siriscan/MARI-Quadcopter-Drone/README.md

# MARI-Quadcopter-Drone
A final senior project created by Seth Iris Canonigo, Christopher Ruiz-Guerra, Nahom Solomon, and Connor Prior


*(Omori is a good game btw)*

# 3D PCB


Read 'Report.pdf' for the full project writeup.
