siriscan/MARI-Quadcopter-Drone/netlist.txt

Netlist

Exported from UPDATED-PCB.sch at 5/2/2026 4:03 PM

EAGLE Version 9.7.0 Copyright (c) 1988-2026 Autodesk, Inc.

Net                 Part     Pad      Pin        Sheet

BOOT                R6       1        1          1
                    U1       4        !BOOT      1
                    U3       77       PA15       1

FGND                C7       1        1          1
                    L3       2        2          1

GND                 BOOT     1        NC         1
                    C1       2        2          1
                    C10      1        1          1
                    C11      1        1          1
                    C12      1        1          1
                    C13      1        1          1
                    C14      1        1          1
                    C15      1        1          1
                    C2       2        2          1
                    C21      2        2          1
                    C22      2        2          1
                    C23      1        1          1
                    C27      1        1          1
                    C28      1        1          1
                    C29      2        2          1
                    C2A      2        2          1
                    C2B      2        2          1
                    C3       2        2          1
                    C30      2        2          1
                    C31      2        2          1
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
                    U3       36       PB2        1

PB5                 JP3      2        2          1
                    U3       91       PB5        1

PB6                 JP3      1        1          1
                    U3       92       PB6        1

PB12                JP1      1        1          1
                    U3       51       PB12       1

PB13                JP1      2        2          1
                    U3       52       PB13       1

PB13_2              JP2      14       14         1
                    U3       43       PB13_2     1

PB14                JP1      3        3          1
                    U3       53       PB14       1

PB14_2              JP2      15       15         1
                    U3       44       PB14_2     1

PB15                PWM-OUT  7        7          1
                    U3       54       PB15       1

PC1                 U$13     1        1          1
                    U3       16       PC1        1

PC2                 U$13     2        2          1
                    U3       17       PC2        1

PC3                 U$13     3        3          1
                    U3       18       PC3        1

PC4                 JP2      3        3          1
                    U3       32       PC4        1

PC5                 JP2      4        4          1
                    U3       33       PC5        1

PC6                 PWM-OUT  3        3          1
                    U3       63       PC6        1

PC7                 JP1      11       11         1
                    U3       64       PC7        1

PC8                 JP1      12       12         1
                    U3       65       PC8        1

PC9                 JP1      13       13         1
                    U3       66       PC9        1

PC10                JP3      13       13         1
                    U3       78       PC10       1

PC11                JP3      12       12         1
                    U3       79       PC11       1

PC12                JP3      11       11         1
                    U3       80       PC12       1

PD0                 INT      TP       TP         1
                    U1       14       !H_INT     1
                    U3       81       PD0        1

PD1                 TP1      TP       TP         1
                    U3       82       PD1        1
                    U4       7        INT        1

PD2                 JP3      8        8          1
                    U3       83       PD2        1

PD3                 JP3      7        7          1
                    U3       84       PD3        1

PD4                 JP3      6        6          1
                    U3       85       PD4        1

PD5                 JP3      5        5          1
                    U3       86       PD5        1

PD6                 JP3      4        4          1
                    U3       87       PD6        1

PD7                 JP3      3        3          1
                    U3       88       PD7        1

PD8                 JP1      4        4          1
                    U3       55       PD8        1

PD9                 JP1      5        5          1
                    U3       56       PD9        1

PD10                JP1      6        6          1
                    U3       57       PD10       1

PD11                JP1      7        7          1
                    U3       58       PD11       1

PD12                PWM-IN   7        7          1
                    U3       59       PD12       1

PD13                JP1      8        8          1
                    U3       60       PD13       1

PD14                JP1      9        9          1
                    U3       61       PD14       1

PD15                JP1      10       10         1
                    U3       62       PD15       1

PE2                 U$1      1        1          1
                    U3       1        PE2        1

PE3                 U$1      2        2          1
                    U3       2        PE3        1

PE4                 U$1      3        3          1
                    U3       3        PE4        1

PE5                 PWM-OUT  5        5          1
                    U3       4        PE5        1

PE6                 U$1      4        4          1
                    U3       5        PE6        1

PE7                 JP2      8        8          1
                    U3       37       PE7        1

PE8                 JP2      9        9          1
                    U3       38       PE8        1

PE9                 PWM-OUT  1        1          1
                    U3       39       PE9        1

PE10                JP2      11       11         1
                    U3       40       PE10       1

PE11                JP2      12       12         1
                    U3       41       PE11       1

PE12                JP2      13       13         1
                    U3       42       PE12       1

PE15                JP2      16       16         1
                    U3       45       PE15       1

RXD                 LORA     4        4          1
                    U3       97       PE0        1

SCL                 R17      1        1          1
                    SCL0     TP       TP         1
                    U1       19       H_SCL/SCK/RX 1
                    U3       46       PB10       1

SCL1                R8       2        2          1
                    SCL1     TP       TP         1
                    U3       95       PB8        1
                    U4       2        SCK        1

SDA/BNO             R16      1        1          1
                    SDA0     TP       TP         1
                    U1       20       H_SDA/H_MISO/TX 1
                    U3       47       PB11       1

SDA1                R7       2        2          1
                    SDA1     TP       TP         1
                    U3       93       PB7        1
                    U4       4        SDI        1

SW                  C34      1        1          1
                    L1       2        2          1
                    U5       5        SW         1

TCK/SWCLK           SWD      2        2          1
                    U3       76       PA14       1

TDO/SWO             SWD      6        6          1
                    U3       89       PB3        1

TMS/SWDIO           SWD      4        4          1
                    U3       72       PA13       1

TXD                 LORA     3        3          1
                    U3       98       PE1        1

V3P3A               BOOT     3        NO         1
                    C12      2        2          1
                    C21      1        1          1
                    C22      1        1          1
                    C23      2        2          1
                    C27      2        2          1
                    C28      2        2          1
                    C29      1        1          1
                    C3       1        1          1
                    C30      1        1          1
                    C38      1        1          1
                    C39      2        2          1
                    C40      2        2          1
                    D3       2        A          1
                    JP4      1        1          1
                    JP4      3        3          1
                    JP4      5        5          1
                    JP4      7        7          1
                    JP4      9        9          1
                    R7       1        1          1
                    R8       1        1          1
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
                    U$4      P$1      P$1        1
                    U$6      P$1      P$1        1
                    U$8      P$1      P$1        1
                    U5       2        EN         1
                    U5       3        VIN        1
