siriscan/MARI-Quadcopter-Drone/PCB.png

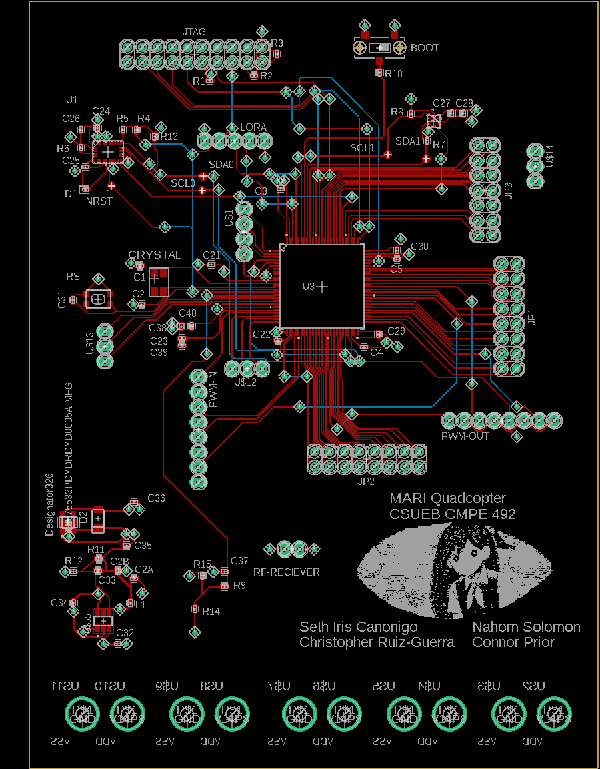
PCB.png
