siriscan/MARI-Quadcopter-Drone/Schematic.png

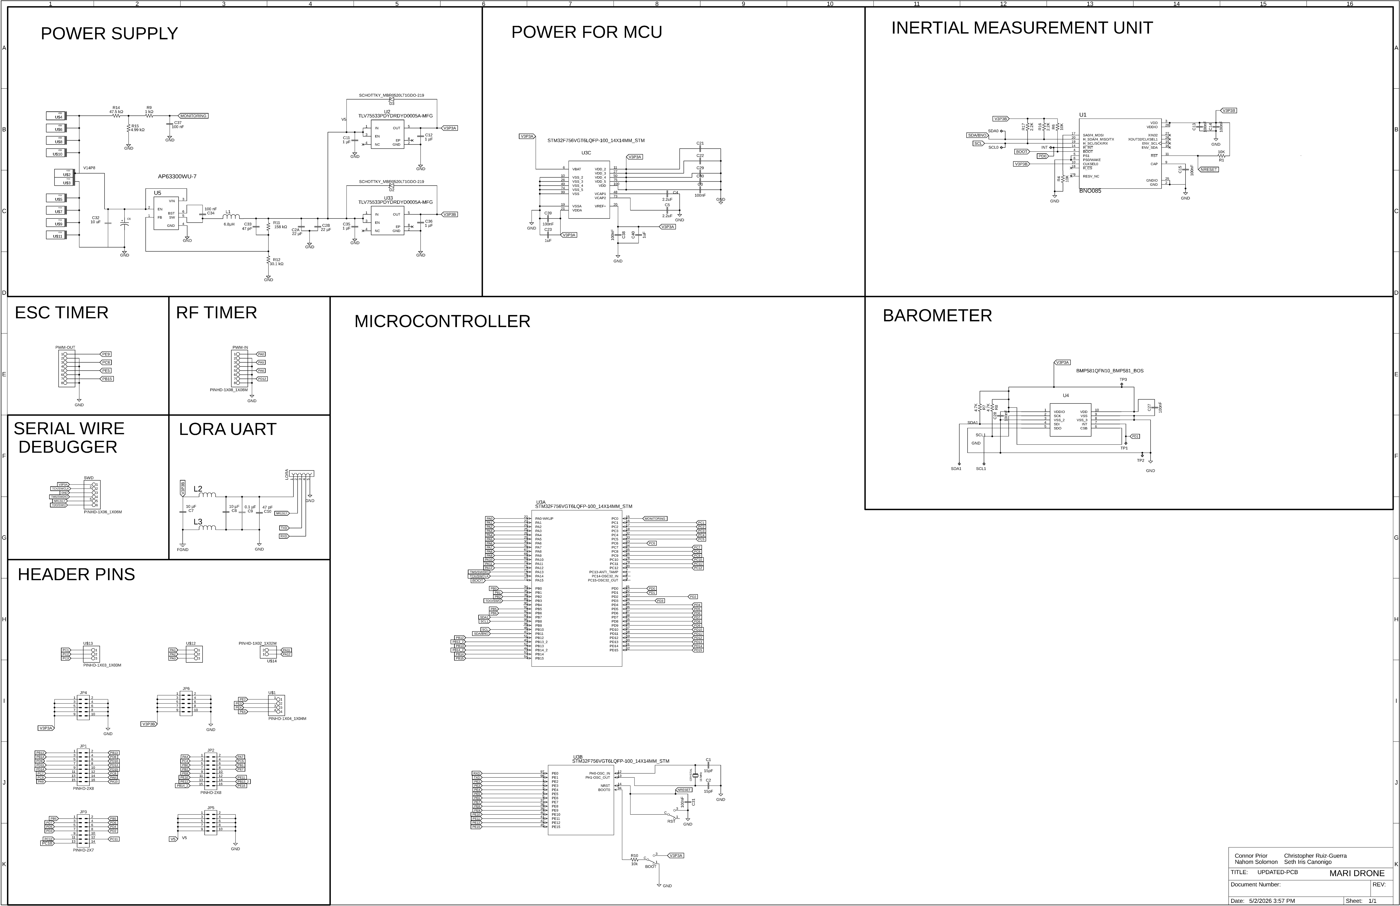
Schematic.png
