siriscan/MARI-Quadcopter-Drone/Updated_MARI_OnBoardBom.xlsx

Item # | *Ref Des | *Qty | Manufacturer | *Mfg Part # | Description / Value | *Package | Type | Your Instructions / Notes | Unit Cost | Total Cost | Website
1 | BMP581 | 1 | Bosch Sensortech | BMP581 | BMP581 Barometer | 10-LGA | Surface Mount |  | 2.92 | 2.92 | link (https://www.digikey.com/en/products/detail/bosch-sensortec/BMP581/16036134)
2 | BOOT, RST | 2 | Nidec Components Corporation | CL-SB-12B-01T | SPDT Switches (Slide Switch) | NA | Surface Mount |  | 1.1 | 2.2 | link (https://www.digikey.com/en/products/detail/nidec-components-corporation/CL-SB-12B-01T/3507823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)
3 | C1,C2 | 2 | Kemet | C0402C150J8HACTU | Capacitor 15pF | 402 | Surface Mount |  | 0.1 | 0.2 | link (https://www.digikey.com/en/products/detail/kemet/C0402C150J8HACTU/7945104)
4 | C2A,C2B | 2 | Samsung Electromechanics | CL05A226MQ5N6J8 | Capacitor 22 µF | 402 | Surface Mount |  | 0.47 | 0.94 | link (https://www.digikey.com/en/products/detail/samsung-electro-mechanics/CL05A226MQ5N6J8/7320595)
5 | C3, C9, C13, C14, C15, C21, C22, C26, C27, C28, C29, C30, C31, C34, C37, C38, C39 | 17 | Samsung Electromechanics | CL05A104KA5NNNC | Capacitor 100nF | 402 | Surface Mount |  | 0.1 | 1.7 | link (https://www.digikey.com/en/products/detail/samsung-electro-mechanics/CL05A104KA5NNNC/3886701)
6 | C4,C5 | 2 | Samsung Electromechanics | CL05A225KP5NSNC | Capacitor 2.2uF | 402 | Surface Mount |  | 0.14 | 0.28 | link (https://www.digikey.com/en/products/detail/samsung-electro-mechanics/CL05A225KP5NSNC/3886766)
7 | C11, C12, C23,C35,C36,C40 | 6 | Samsung Electromechanics | CL05A105KP5NNNC | Capacitor 1uF | 402 | Surface Mount |  | 0.1 | 0.6 | link (https://www.digikey.com/en/products/detail/samsung-electro-mechanics/CL05A105KP5NNNC/3886734)
8 | C7, C8, C32 | 3 | Murata Electronics | GRM21BR61H106KE43L | Capacitor 10 uF | 805 | Surface Mount |  | 0.3 | 0.9 | link (https://www.digikey.com/en/products/detail/murata-electronics/GRM21BR61H106KE43L/10326316)
9 | CRYSTAL | 1 | NDK (NIHON DEMPA KOGYO CO., LTD) | STDCRG1-16M | Crystal 16 MHz | No Lead | Surface Mount |  | 0.61 | 0.61 | link (https://www.digikey.com/en/products/detail/ndk-nihon-dempa-kogyo-co-ltd/STDCRG1-16M/2261470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)
10 | D2, D3 | 2 | MCC (Micro Commercial Components) | SM5817PL-TP | Schottky Diode | SOD-123 | Surface Mount |  | 0.15 | 0.3 | link (https://www.digikey.com/en/products/detail/mcc-micro-commercial-components/SM5817PL-TP/1793251)
11 | GND,INT,NRST,SDA0,SCL0,SCL1,SDA1,TP1,TP2,TP3,V3P3 | 11 | NA | NA | Test pad |  | Exposed Copper |  | NA |  | NA
12 | JP1,JP2 | 2 | Amphenol ICC | 10129381-916001BLF | PINHD-2X8 |  | Through hole |  | 0.69 | 1.38 | link (https://www.digikey.com/en/products/detail/amphenol-cs-fci/10129381-916001BLF/7916090)
13 | JP3 | 1 | Amphenol ICC | 10129381-914004BLF | PINHD-2X7 |  | Through hole |  | 0.29 | 0.29 | link (https://www.digikey.com/en/products/detail/amphenol-cs-fci/10129381-914004BLF/7916089)
14 | JP4,JP5 | 2 | Amphenol ICC | 67997-210HLF | PINHD-2X5 |  | Through hole |  | 0.77 | 1.54 | link (https://www.digikey.com/en/products/detail/amphenol-cs-fci/67997-210HLF/1878541)
15 | LORA | 1 | Amphenol ICC | 75915-305LF | FEMALE-HEADER-1X5 |  | Through hole |  | 0.6 | 0.6 | link (https://www.digikey.com/en/products/detail/amphenol-cs-fci/75915-305LF/1523411)
16 | PWM-IN,PWM-OUT | 2 | Amphenol ICC | 10129378-908001BLF | PINHD-1X08 |  | Through hole |  | 0.38 | 0.76 | link (https://www.digikey.com/en/products/detail/amphenol-cs-fci/10129378-908001BLF/7915949)
17 | L1 | 1 | Wurth Electroniks | 74437334068 | Inductor 6.8 µH | 5020 | Surface Mount |  | 2.55 | 2.55 | link (https://www.digikey.com/en/products/detail/w%C3%BCrth-elektronik/74437334068/5051065)
18 | R1,R4, R6, R10 | 3 | Panasonic Electronic Components | ERA-2AEB103X | Resistors 10k | 402 | Surface Mount |  | 0.1 | 0.3 | link (https://www.digikey.com/en/products/detail/panasonic-electronic-components/ERA-2AEB103X/1706029)
19 | R12 | 1 | YAGEO | RC0402FR-0730K1L | Resistor 30.1k | 402 | Surface Mount |  | 0.1 | 0.1 | link (https://www.digikey.com/en/products/detail/yageo/RC0402FR-0730K1L/726587)
20 | R16,R17 | 2 | YAGEO | RC0402FR-072K2L | Resistors 2.2k | 402 | Surface Mount |  | 0.1 | 0.2 | link (https://www.digikey.com/en/products/detail/yageo/RC0402FR-072K2L/726553)
21 | R5,R13 | 2 | Panasonic Electronic Components | ERA-2AEB4022X | Resistors 40.2k | 402 | Surface Mount |  | 0.1 | 0.2 | link (https://www.digikey.com/en/products/detail/panasonic-electronic-components/ERA-2AEB4022X/2026197)
22 | R7,R8,R15 | 3 | YAGEO | RC0402JR-074K7L | Resistors 4.7K | 402 | Surface Mount |  | 0.1 | 0.3 | link (https://www.digikey.com/en/products/detail/yageo/RC0402JR-074K7L/726477)
23 | R9 | 1 | Panasonic Electronic Components | ERJ-2RKF1001X | Resistors 1K | 402 | Surface Mount |  | 0.1 | 0.1 | link (https://www.digikey.com/en/products/detail/panasonic-electronic-components/ERJ-2RKF1001X/79729)
24 | R11 | 1 | YAGEO | RC0402FR-07158KL | Resistor 158k | 402 | Surface Mount |  | 0.1 | 0.1 | link (https://www.digikey.com/en/products/detail/yageo/RC0402FR-07158KL/5280850)
25 | R14 | 1 | YAGEO | RC0402JR-0747KL | Resistors 47.5k | 402 | Surface Mount |  | 0.1 | 0.1 | link (https://www.digikey.com/en/products/detail/yageo/RC0402JR-0747KL/726485)
26 | RF-RECIEVER,U$14 | 2 | Amphenol ICC | 68000-102HLF | PINHD-1X02 |  | Through hole |  | 0.22 | 0.44 | link (https://www.digikey.com/en/products/detail/amphenol-cs-fci/68000-102HLF/1493545)
27 | U$1 | 1 | Amphenol ICC | 10129378-904001BLF | PINHD-1X04 |  | Through hole |  | 0.25 | 0.25 | link (https://www.digikey.com/en/products/detail/amphenol-cs-fci/10129378-904001BLF/7915932)
28 | U$2,U$4,U$6,U$8,U$10 | 5 | NA | NA | Gold-Plated 4mm 4.0mm Female Banana Plug Bullet Connector Adapter connected to VDD |  | Through hole |  | NA |  | NA
29 | U$3,U$5,U$7,U$9,U$11 | 5 | NA | NA | Gold-Plated 4mm 4.0mm Female Banana Plug Bullet Connector Adapter connected to VSS |  | Through hole |  | NA |  | NA
30 | U$12,U$13 | 2 | Amphenol ICC | 68001-203HLF | PINHD-1X03 |  | Through hole |  | 0.24 | 0.48 | link (https://www.digikey.com/en/products/detail/amphenol-cs-fci/68001-203HLF/2023312)
31 | U$55 | 1 | Diodes Inc. | AP63300WU-7 | 5 V Buck Converter | SOT-23-6 Thin | Surface Mount |  | 0.84 | 0.84 | link (https://www.digikey.com/en/products/detail/diodes-incorporated/AP63300WU-7/10491510)
32 | U5 | 1 | CEVA Technologies | BNO085 | BNO085 IMU | 28-LGA | Surface Mount |  | 12.34 | 12.34 | link (https://www.digikey.com/en/products/detail/ceva-technologies-inc/BNO085/9445940)
33 | U3 | 1 | STMicroelectronics | STM32F756VGT6 | STM32F756VGT6 Microcontroller | 100-LQFP | Surface Mount |  | 17.92 | 17.92 | link (https://www.digikey.com/en/products/detail/stmicroelectronics/STM32F756VGT6/6137828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)
34 | U33, U2 | 2 | Texas Instruments | TLV75533PDYDR | 3.3 V LDO | SC-74A | Surface Mount |  | 0.29 | 0.58 | link (https://www.digikey.com/en/products/detail/texas-instruments/TLV75533PDYDR/22531567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)
35 | C6 | 1 | EPCOS - TDK Electronics | B41866C5108M000 | Capacitor 1000uF |  | Through hole |  | 1.68 | 1.68 | link (https://www.digikey.com/en/products/detail/epcos-tdk-electronics/B41866C5108M000/5844975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)
36 | L2, L3 | 2 | Murata Electronics | BLM15EG121SN1D | Ferrite Beads 120 ohms | 402 | Surface Mount |  | 0.16 | 0.32 | link (https://www.digikey.com/en/products/detail/murata-electronics/BLM15EG121SN1D/1016163)
37 | C10, C33 | 2 | Murata Electronics | GRM1555C1H470JA01D | Capacitor 47pF | 402 | Surface Mount |  | 0.1 | 0.2 | link (https://www.digikey.com/en/products/detail/murata-electronics/GRM1555C1H470JA01D/3693853)
 |  |  |  |  |  |  |  |  | Total: | 54.22
 |  |  |  |  |  |  |  |  |  | 271.1
 | # of SMD | 62
 | # of TH | 24
 | # of BGA/QFP | 3
