siriscan/MARI-Quadcopter-Drone/(list of files, cad)

Other CAD files:
MARI F3Z.f3z
