siriscan/MARI-Quadcopter-Drone/MARI BRD.brd

## EAGLE design MARI BRD.brd (2026-05-13)

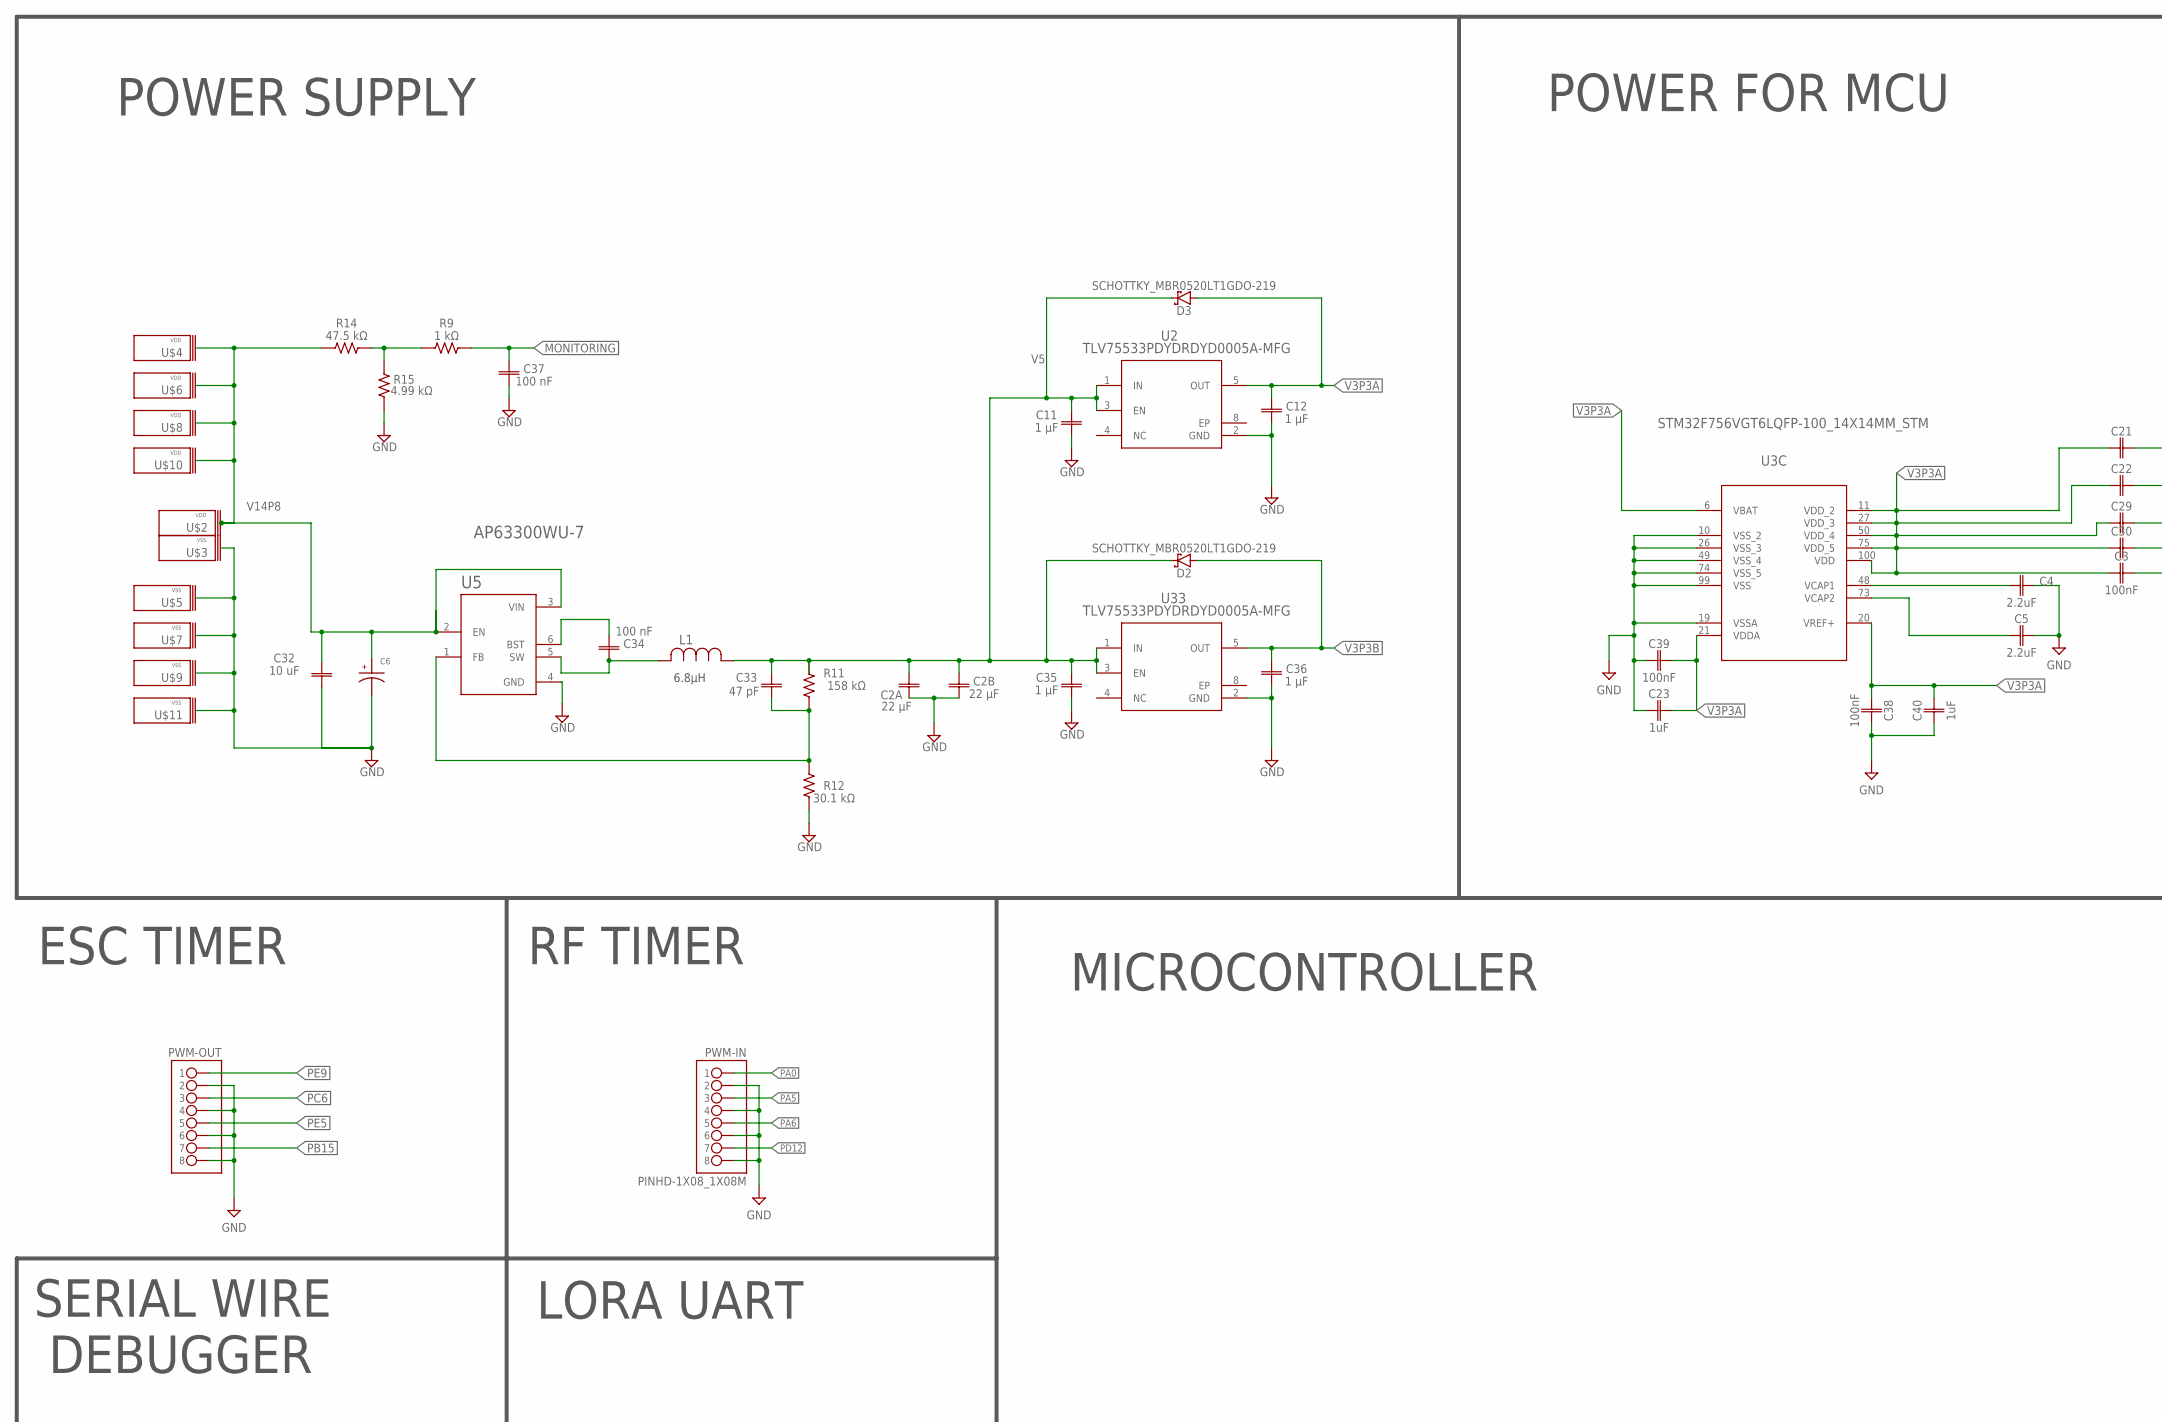
[picture p23: schematic MARI SCH.sch, part in row 1, column 1]

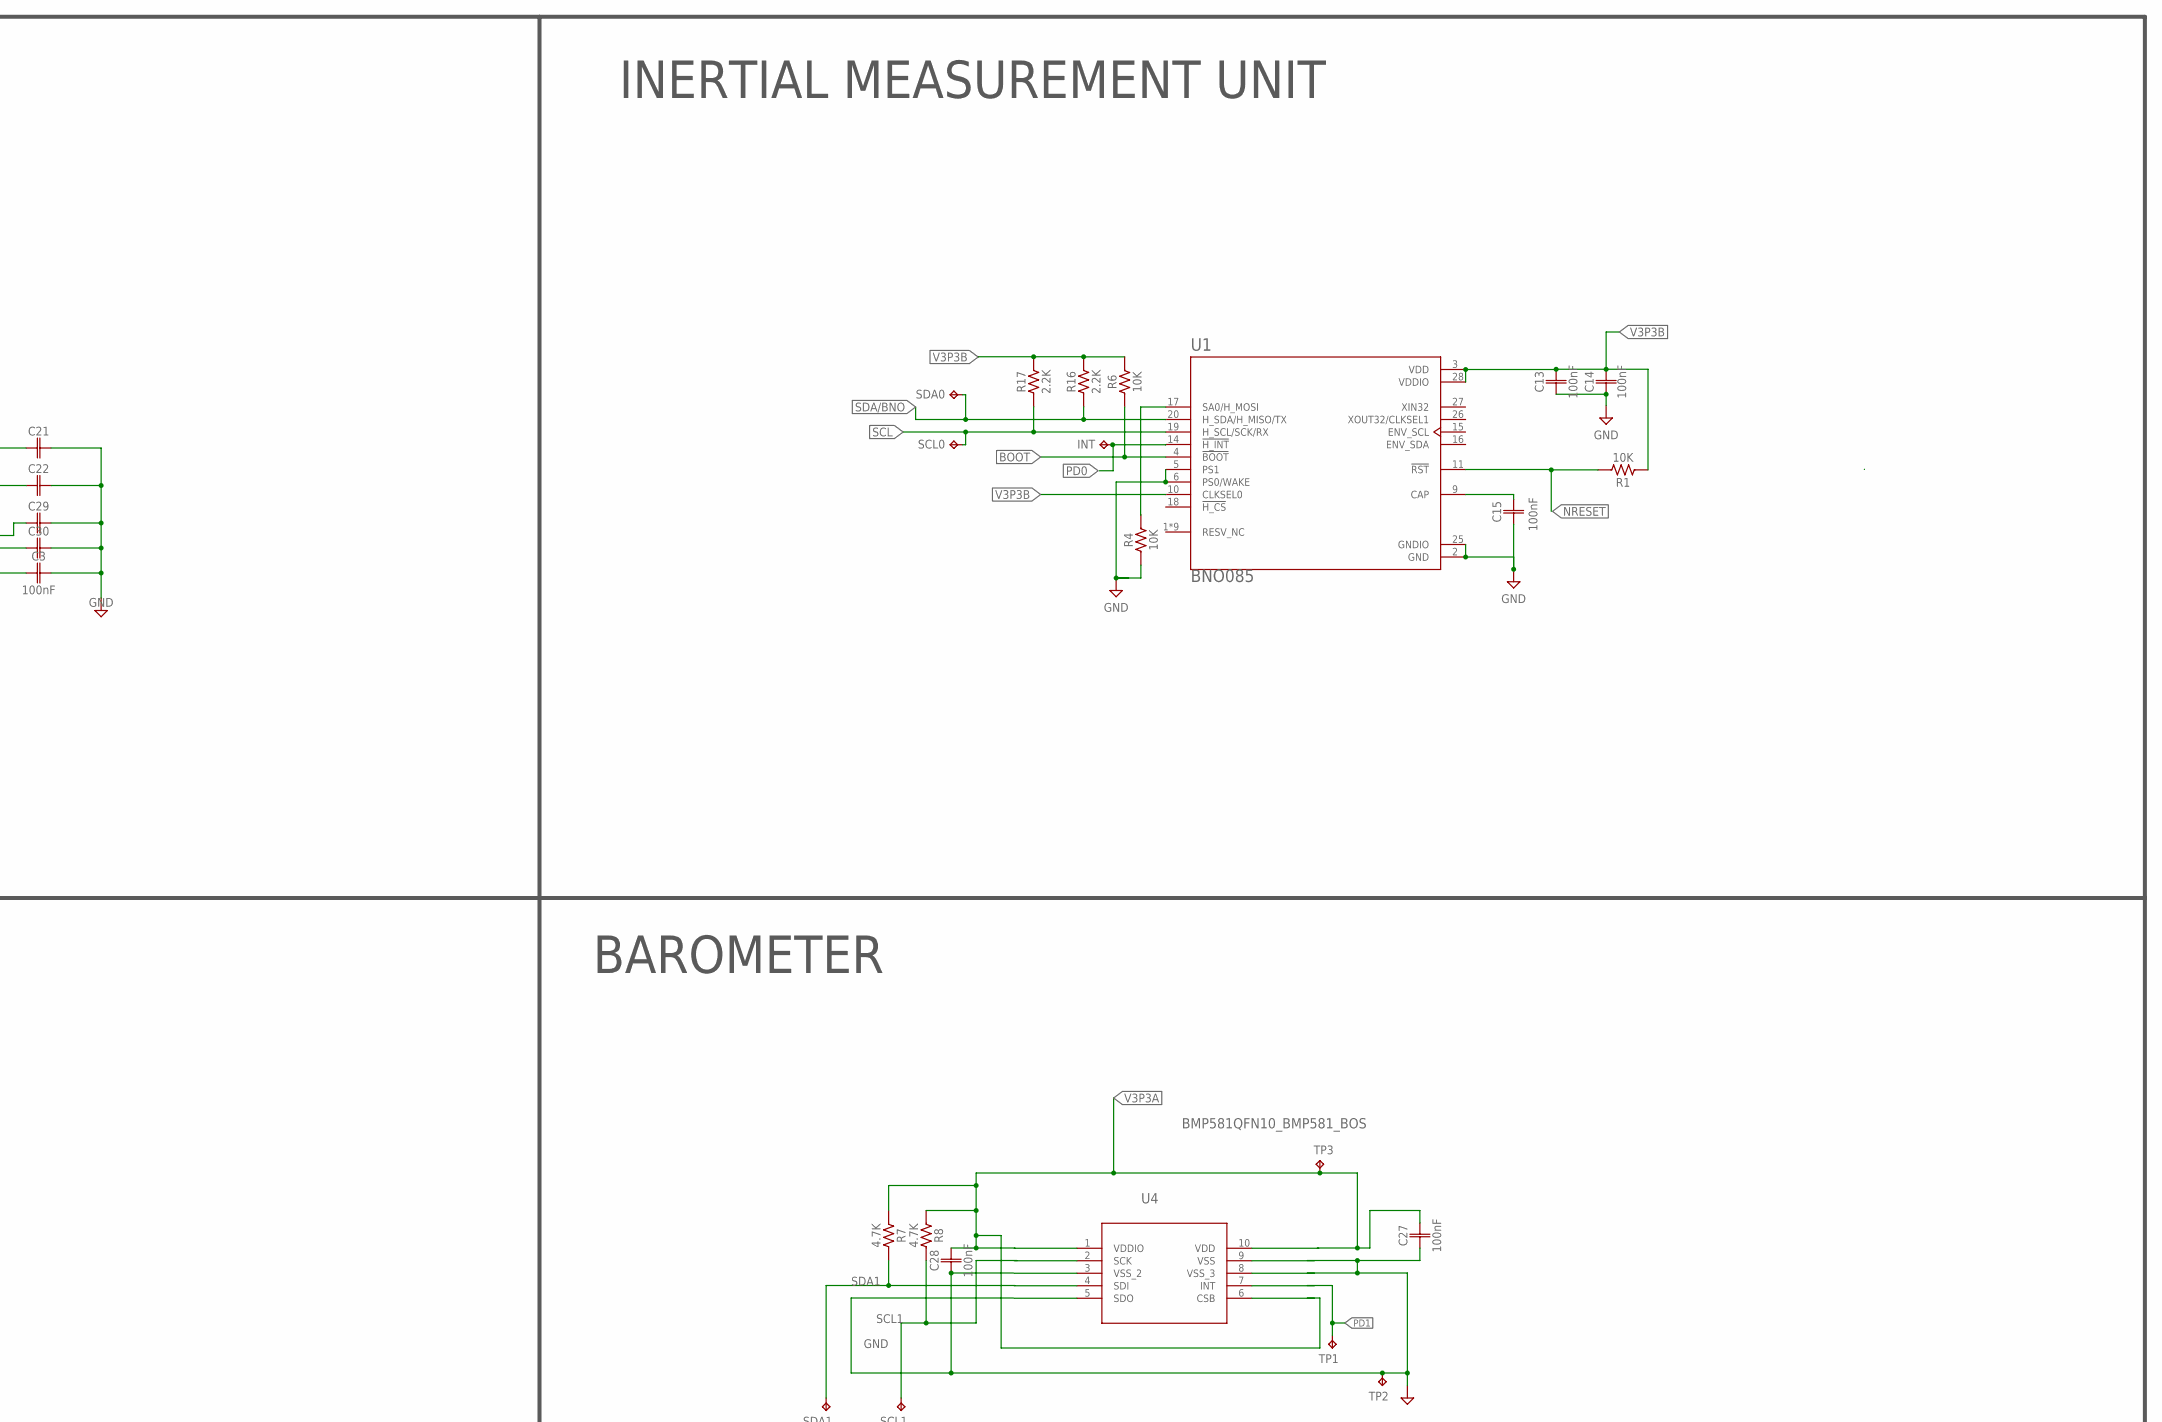
[picture p24: schematic MARI SCH.sch, part in row 1, column 2]

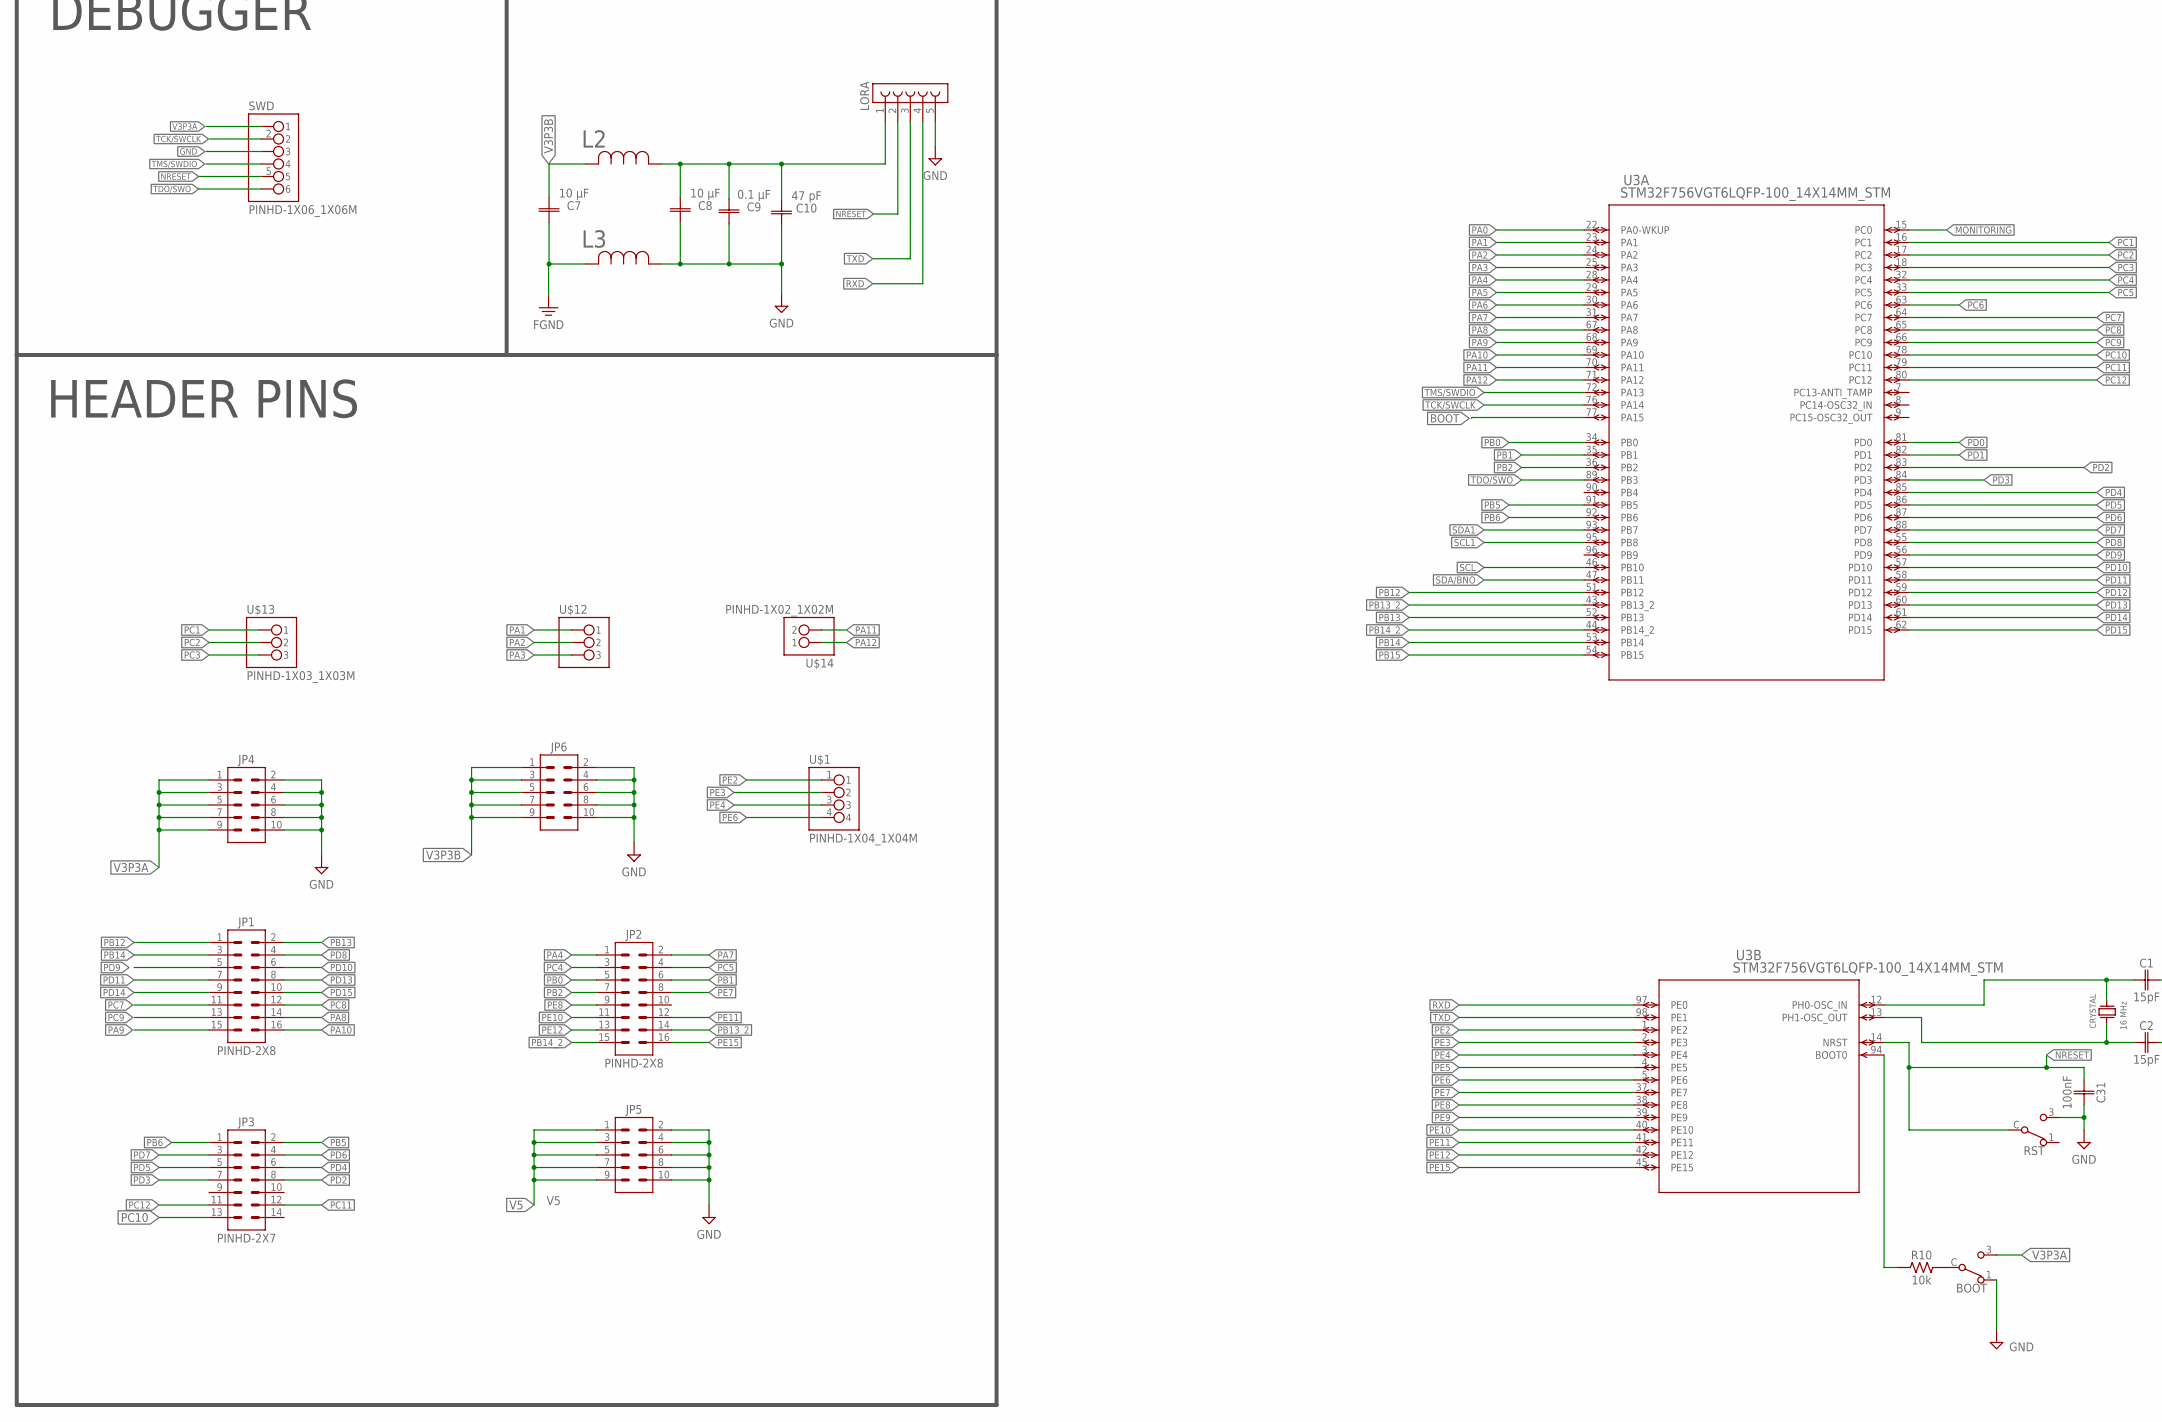
[picture p25: schematic MARI SCH.sch, part in row 2, column 1]

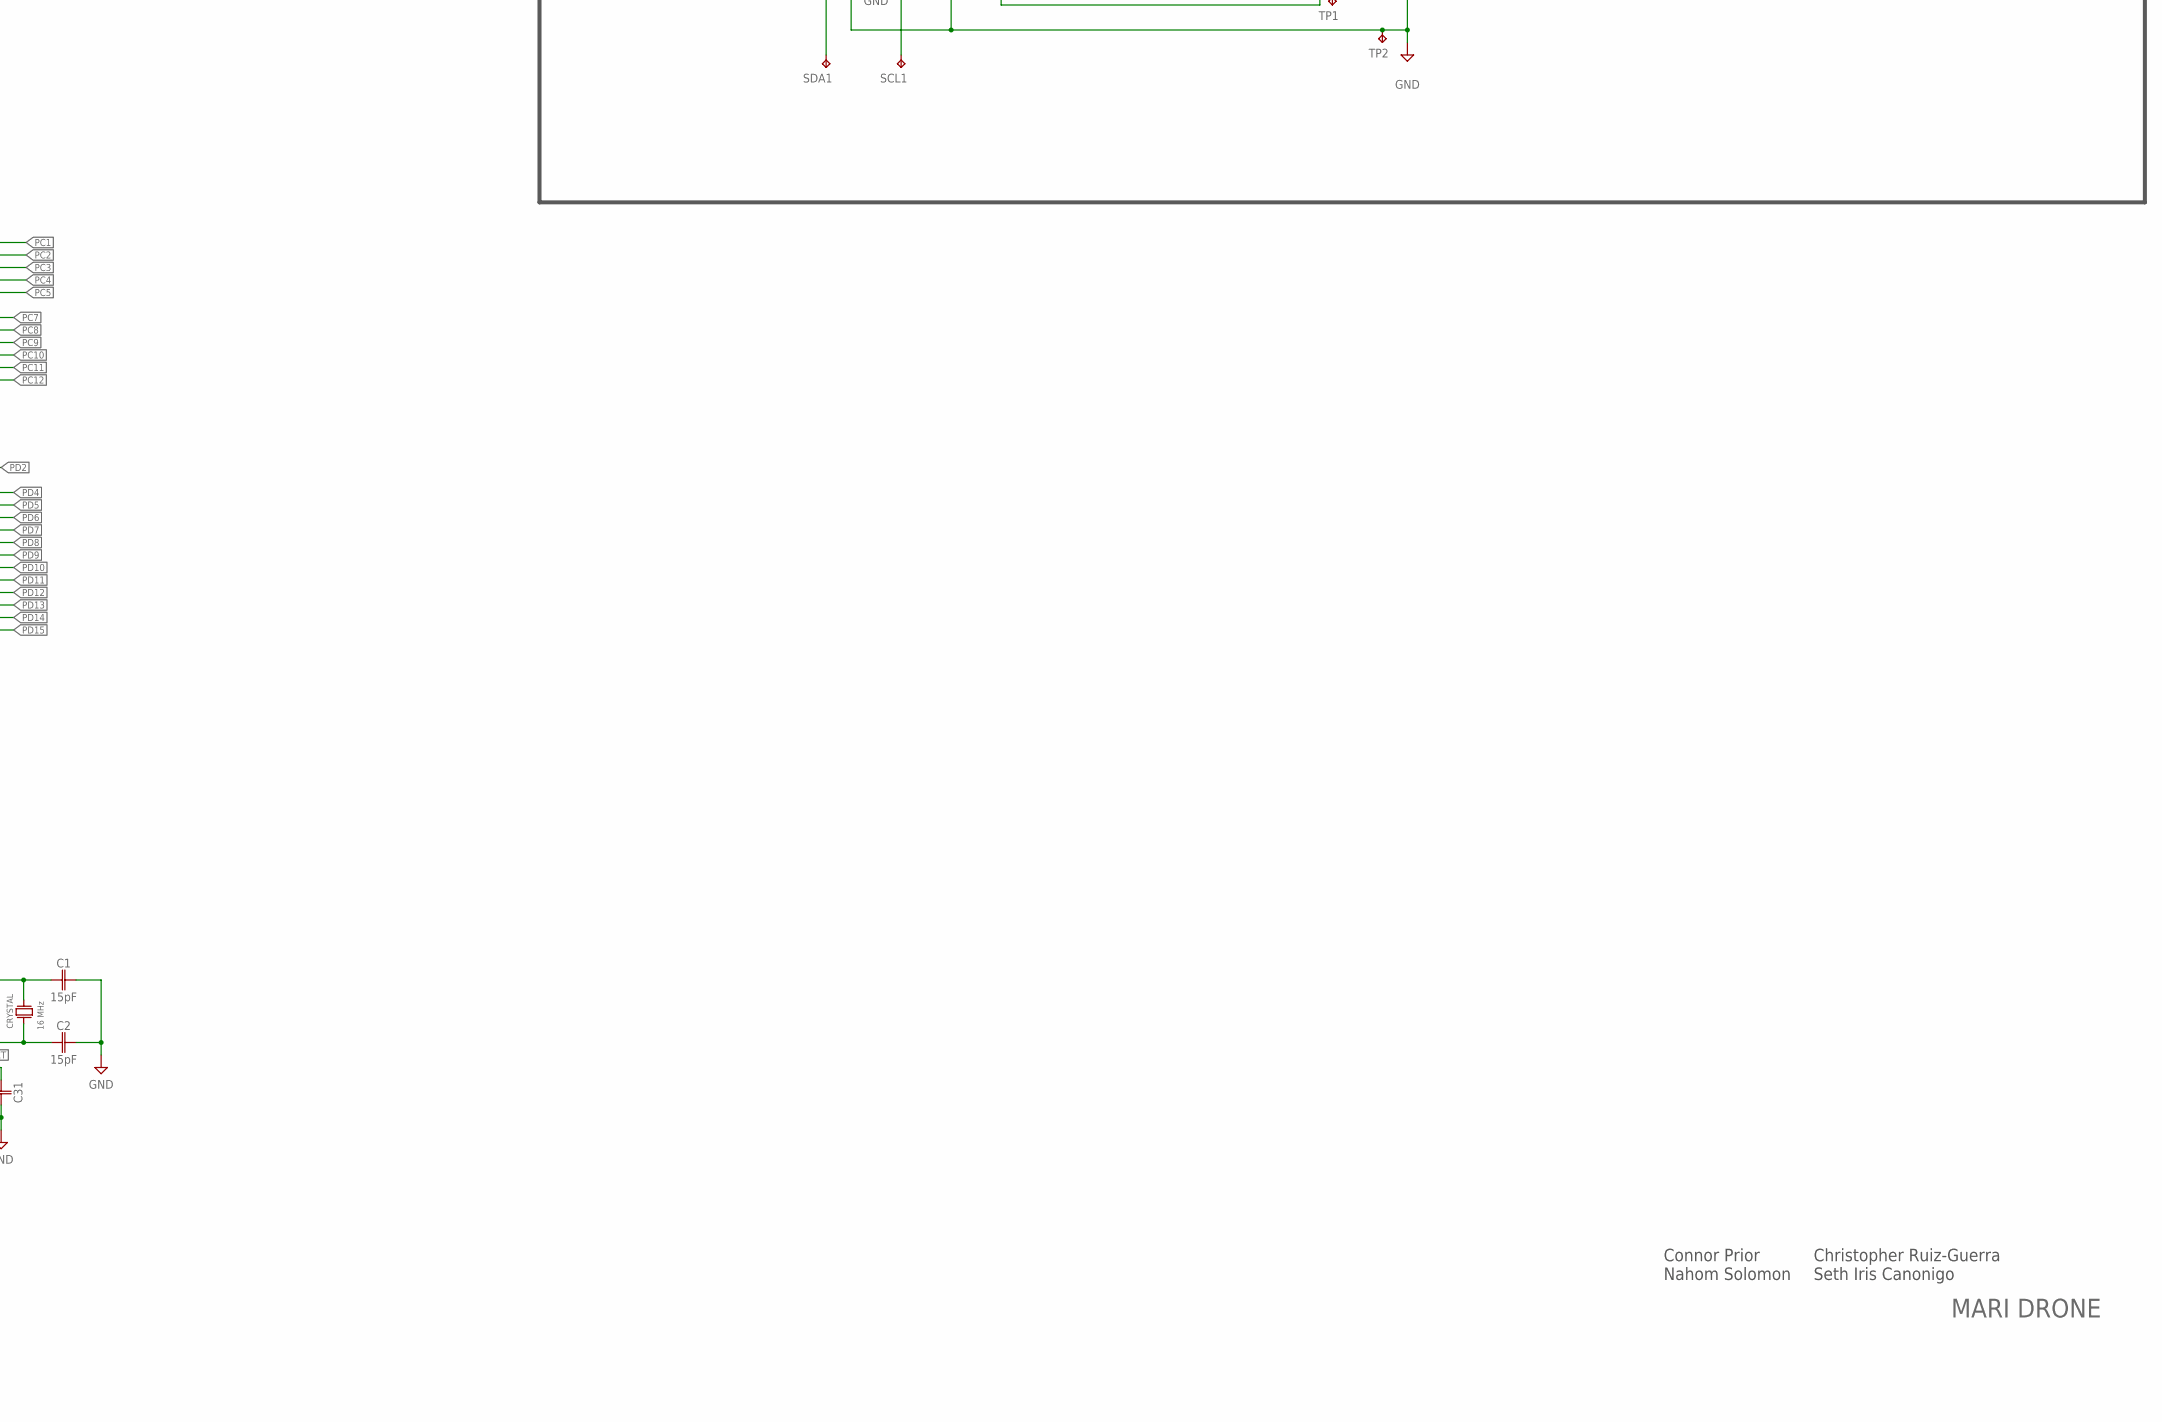
[picture p26: schematic MARI SCH.sch, part in row 2, column 2]

Parts:
BOOT: SPDT_SWITCH_CL-SB-12B-01T; CL-SB-12B-01T
C1, C2: 15pF; CAPC1005X60
C2A, C2B: 22 µF; CAPC1005X60
C3, C13, C14, C15, C21, C22, C27, C28, C29, C30, C31, C38, C39: 100nF; CAPC1005X60
C4, C5: 2.2uF; CAPC1005X60
C6: B41866C5108M000; CAPPRD500W60D1250H2200
C7, C8: 10 µF; CAPC1005X60
C9: 0.1 µF; CAPC1005X60
C10, C33: 47 pF; CAPC1005X60
C11, C12, C35, C36: 1 µF; CAPC1005X60
C23, C40: 1uF; CAPC1005X60
C32: 10 uF; CAPC2012X110
C34, C37: 100 nF; CAPC1005X60
CRYSTAL: 16 MHz; STDCRG1-16M
D2, D3: SCHOTTKY_MBR0520LT1GDO-219; SODFL3718X115
INT: TPB1,27; B1,27
JP1, JP2: PINHD-2X8; 2X08
JP3: PINHD-2X7; 2X07
JP4, JP5, JP6: PINHD-2X5; 2X05
L1: 74437334068IND_WE-LHMI_5020_WRE; IND_WE-LHMI_5020_WRE
L2, L3: BLM15EG121SN1DIND_BLM15_0402_MUR-M; IND_BLM15_0402_MUR-M
LORA: FEMALE-HEADER-1X5; 1X05
PWM-IN: PINHD-1X08_1X08M; 1X08
PWM-OUT: PINHD-1X08_1X08M; 1X08
R1, R4, R6: 10K; RESC1005X40
R7, R8: 4.7K; RESC1005X40
R9: 1 kΩ; RESC1005X40
R10: 10k; RESC1005X40
R11: 158 kΩ; RESC1005X40
R12: 30.1 kΩ; RESC1005X40
R14: 47.5 kΩ; RESC1005X40
R15: 4.99 kΩ; RESC1005X40
R16, R17: 2.2K; RESC1005X40
RST: SPDT_SWITCH_CL-SB-12B-01T; CL-SB-12B-01T
SCL0, SCL1: TPB1,27; B1,27
SDA0, SDA1: TPB1,27; B1,27
SWD: PINHD-1X06_1X06M; 1X06
TP1, TP2, TP3: TPB1,27; B1,27
U1: BNO085; IC_BNO085
U2, U33: TLV75533PDYDRDYD0005A-MFG; DYD0005A-MFG
U3: STM32F756VGT6LQFP-100_14X14MM_STM; LQFP-100_14X14MM_STM
U4: BMP581QFN10_BMP581_BOS; QFN10_BMP581_BOS
U5: AP63300WU-7; SOT95P280X100-6N
U$1: PINHD-1X04_1X04M; 1X04
U$2, U$4, U$6, U$8, U$10: VDD; 4MM_PLUG
U$3, U$5, U$7, U$9, U$11: VSS; 4MM_PLUG
U$12, U$13: PINHD-1X03_1X03M; 1X03
U$14: PINHD-1X02_1X02M; 1X02

Connections:
BOOT: R6.1, U1.4 (!BOOT), U3.77 (PA15)
FGND: C7.1, L3.2
GND: BOOT.1 (NC), C1.2, C2.2, C2A.2, C2B.2, C3.2, C4.2, C5.2, C6.2, C8.1, C9.1, C10.1, C11.1, C12.1, C13.1, C14.1, C15.1, C21.2, C22.2, C23.1, C27.1, C28.1, C29.2, C30.2, C31.2, C32.1, C35.1, C36.1, C37.2, C38.2, C39.1, C40.1, JP4.2, JP4.4, JP4.6, JP4.8, JP4.10, JP5.2, JP5.4, JP5.6, JP5.8, JP5.10, JP6.2, JP6.4, JP6.6, JP6.8, JP6.10, L3.1, LORA.5, PWM-IN.2, PWM-IN.4, PWM-IN.6, PWM-IN.8, PWM-OUT.2, PWM-OUT.4, PWM-OUT.6, PWM-OUT.8, R4.1, R12.1, R15.1, RST.3 (NO), SWD.3, TP2.TP, U1.2 (GND), U1.5 (PS1), U1.6 (PS0/WAKE), U1.25 (GNDIO), U2.2 (GND), U3.10 (VSS_2), U3.19 (VSSA), U3.26 (VSS_3), U3.49 (VSS_4), U3.74 (VSS_5), U3.99 (VSS), U4.3 (VSS_2), U4.5 (SDO), U4.8 (VSS_3), U4.9 (VSS), U5.4 (GND), U33.2 (GND), U$3.P$1, U$5.P$1, U$7.P$1, U$9.P$1, U$11.P$1
MONITORING: C37.1, R9.2, U3.15 (PC0)
unnamed: C15.2, U1.9 (CAP)
unnamed: C8.2, C9.2, C10.2, L2.1, LORA.1
unnamed: C34.2, U5.6 (BST)
unnamed: R4.2, U1.17 (SA0/H_MOSI)
unnamed: C33.1, R11.1, R12.2, U5.1 (FB)
unnamed: C1.1, CRYSTAL.P$3, U3.12 (PH0-OSC_IN)
unnamed: C2.1, CRYSTAL.P$1, U3.13 (PH1-OSC_OUT)
unnamed: C4.1, U3.48 (VCAP1)
unnamed: C5.1, U3.73 (VCAP2)
unnamed: R10.1, U3.94 (BOOT0)
unnamed: BOOT.C (COM), R10.2
unnamed: R9.1, R14.1, R15.2
NRESET: C31.1, LORA.2, R1.2, RST.C (COM), SWD.5, U1.11 (!RST), U3.14 (NRST)
PA0: PWM-IN.1, U3.22 (PA0-WKUP)
PA1: U3.23 (PA1), U$12.1
PA2: U3.24 (PA2), U$12.2
PA3: U3.25 (PA3), U$12.3
PA4: JP2.1, U3.28 (PA4)
PA5: PWM-IN.3, U3.29 (PA5)
PA6: PWM-IN.5, U3.30 (PA6)
PA7: JP2.2, U3.31 (PA7)
PA8: JP1.14, U3.67 (PA8)
PA9: JP1.15, U3.68 (PA9)
PA10: JP1.16, U3.69 (PA10)
PA11: U3.70 (PA11), U$14.2
PA12: U3.71 (PA12), U$14.1
PB0: JP2.5, U3.34 (PB0)
PB1: JP2.6, U3.35 (PB1)
PB2: JP2.7, U3.36 (PB2)
PB5: JP3.2, U3.91 (PB5)
PB6: JP3.1, U3.92 (PB6)
PB12: JP1.1, U3.51 (PB12)
PB13: JP1.2, U3.52 (PB13)
PB13_2: JP2.14, U3.43 (PB13_2)
PB14: JP1.3, U3.53 (PB14)
PB14_2: JP2.15, U3.44 (PB14_2)
PB15: PWM-OUT.7, U3.54 (PB15)
PC1: U3.16 (PC1), U$13.1
PC2: U3.17 (PC2), U$13.2
PC3: U3.18 (PC3), U$13.3
PC4: JP2.3, U3.32 (PC4)
PC5: JP2.4, U3.33 (PC5)
PC6: PWM-OUT.3, U3.63 (PC6)
PC7: JP1.11, U3.64 (PC7)
PC8: JP1.12, U3.65 (PC8)
PC9: JP1.13, U3.66 (PC9)
PC10: JP3.13, U3.78 (PC10)
PC11: JP3.12, U3.79 (PC11)
PC12: JP3.11, U3.80 (PC12)
PD0: INT.TP, U1.14 (!H_INT), U3.81 (PD0)
PD1: TP1.TP, U3.82 (PD1), U4.7 (INT)
PD2: JP3.8, U3.83 (PD2)
PD3: JP3.7, U3.84 (PD3)
PD4: JP3.6, U3.85 (PD4)
PD5: JP3.5, U3.86 (PD5)
PD6: JP3.4, U3.87 (PD6)
PD7: JP3.3, U3.88 (PD7)
PD8: JP1.4, U3.55 (PD8)
PD9: JP1.5, U3.56 (PD9)
PD10: JP1.6, U3.57 (PD10)
PD11: JP1.7, U3.58 (PD11)
PD12: PWM-IN.7, U3.59 (PD12)
PD13: JP1.8, U3.60 (PD13)
PD14: JP1.9, U3.61 (PD14)
PD15: JP1.10, U3.62 (PD15)
PE2: U3.1 (PE2), U$1.1
PE3: U3.2 (PE3), U$1.2
PE4: U3.3 (PE4), U$1.3
PE5: PWM-OUT.5, U3.4 (PE5)
PE6: U3.5 (PE6), U$1.4
PE7: JP2.8, U3.37 (PE7)
PE8: JP2.9, U3.38 (PE8)
PE9: PWM-OUT.1, U3.39 (PE9)
PE10: JP2.11, U3.40 (PE10)
PE11: JP2.12, U3.41 (PE11)
PE12: JP2.13, U3.42 (PE12)
PE15: JP2.16, U3.45 (PE15)
RXD: LORA.4, U3.97 (PE0)
SCL: R17.1, SCL0.TP, U1.19 (H_SCL/SCK/RX), U3.46 (PB10)
SCL1: R8.2, SCL1.TP, U3.95 (PB8), U4.2 (SCK)
SDA1: R7.2, SDA1.TP, U3.93 (PB7), U4.4 (SDI)
SDA/BNO: R16.1, SDA0.TP, U1.20 (H_SDA/H_MISO/TX), U3.47 (PB11)
SW: C34.1, L1.2, U5.5 (SW)
TCK/SWCLK: SWD.2, U3.76 (PA14)
TDO/SWO: SWD.6, U3.89 (PB3)
TMS/SWDIO: SWD.4, U3.72 (PA13)
TXD: LORA.3, U3.98 (PE1)
V3P3A: BOOT.3 (NO), C3.1, C12.2, C21.1, C22.1, C23.2, C27.2, C28.2, C29.1, C30.1, C38.1, C39.2, C40.2, D3.2 (A), JP4.1, JP4.3, JP4.5, JP4.7, JP4.9, R7.1, R8.1, SWD.1, TP3.TP, U2.5 (OUT), U3.6 (VBAT), U3.11 (VDD_2), U3.20 (VREF+), U3.21 (VDDA), U3.27 (VDD_3), U3.50 (VDD_4), U3.75 (VDD_5), U3.100 (VDD), U4.1 (VDDIO), U4.6 (CSB), U4.10 (VDD)
V3P3B: C7.2, C13.2, C14.2, C36.2, D2.2 (A), JP6.1, JP6.3, JP6.5, JP6.7, JP6.9, L2.2, R1.1, R6.2, R16.2, R17.2, U1.3 (VDD), U1.10 (CLKSEL0), U1.28 (VDDIO), U33.5 (OUT)
V5: C2A.1, C2B.1, C11.2, C33.2, C35.2, D2.1 (C), D3.1 (C), JP5.1, JP5.3, JP5.5, JP5.7, JP5.9, L1.1, R11.2, U2.1 (IN), U2.3 (EN), U33.1 (IN), U33.3 (EN)
V14P8: C6.1, C32.2, R14.2, U5.2 (EN), U5.3 (VIN), U$2.P$1, U$4.P$1, U$6.P$1, U$8.P$1, U$10.P$1

Notes on the sheet:
MARI DRONE
Connor Prior Nahom Solomon
Christopher Ruiz-Guerra Seth Iris Canonigo
HEADER PINS
LORA UART
SERIAL WIRE DEBUGGER
ESC TIMER
RF TIMER
POWER SUPPLY
POWER FOR MCU
INERTIAL MEASUREMENT UNIT
BAROMETER
MICROCONTROLLER
6.8μH

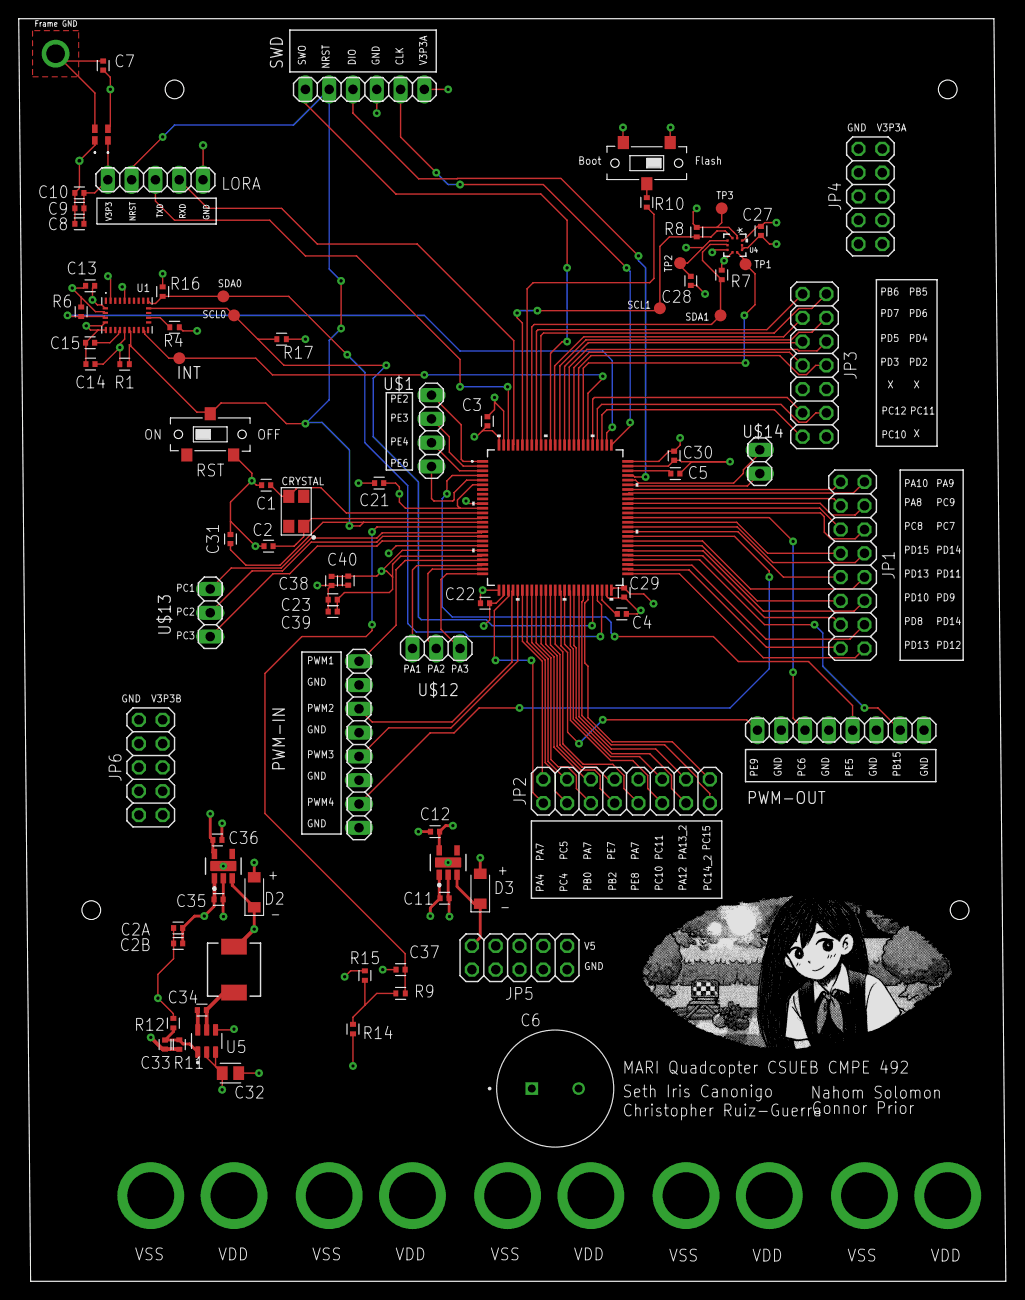
[picture p27: board MARI BRD.brd from above]

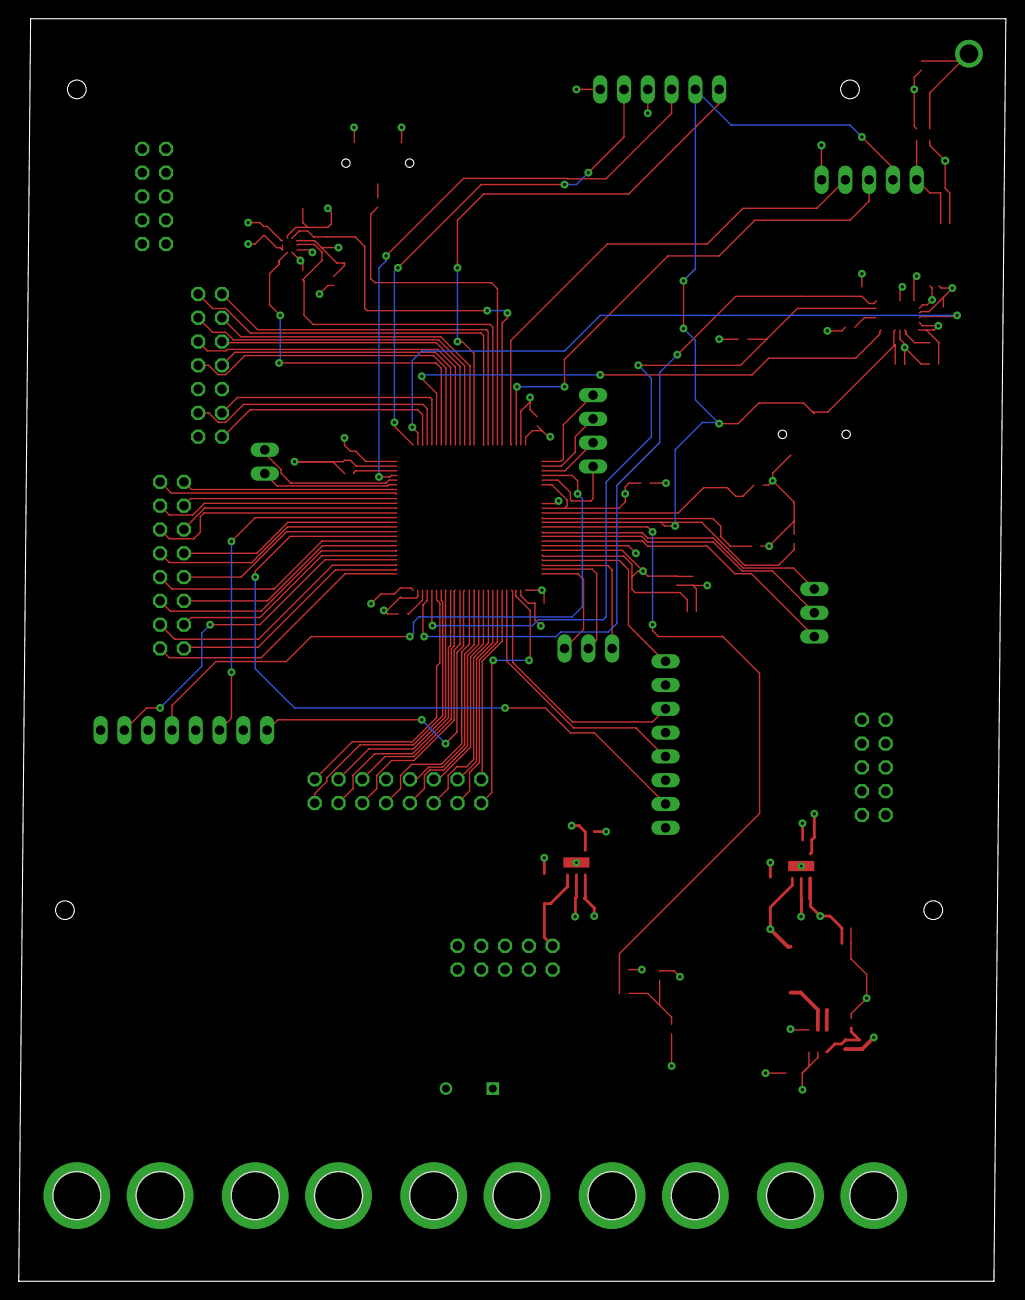
[picture p28: board MARI BRD.brd from below]

Board: 4 copper layers, 105.4 x 134.8 mm, 93 parts (10 on the bottom side), 95 nets.
