siriscan/MARI-Quadcopter-Drone/MARI_PCB_Final_IMU/MARI_PCB_Final_IMU.ioc

Mcu.UserName=STM32F756VGTx
PA0/WKUP.Signal=S_TIM5_CH1
PA10.Signal=GPIO_Output
PA11.Signal=GPIO_Output
PA12.Signal=GPIO_Output
PA13.Signal=SYS_JTMS-SWDIO
PA14.Signal=SYS_JTCK-SWCLK
PA5.Signal=S_TIM2_CH1_ETR
PA6.Signal=S_TIM3_CH1
PB10.Signal=I2C2_SCL
PB11.Signal=I2C2_SDA
PB15.Signal=S_TIM12_CH2
PB7.Signal=I2C1_SDA
PB8.Signal=I2C1_SCL
PC0.Signal=ADCx_IN10
PC6.Signal=S_TIM8_CH1
PD0.GPIO_Label=BNO_INTN
PD0.Signal=GPXTI0
PD12.Signal=S_TIM4_CH1
PE0.Signal=UART8_RX
PE1.Signal=UART8_TX
PE5.Signal=S_TIM9_CH1
PE9.Signal=S_TIM1_CH1
PH0/OSC_IN.Signal=RCC_OSC_IN
PH1/OSC_OUT.Signal=RCC_OSC_OUT
