siriscan/MARI-Quadcopter-Drone/(notices)

Notices in the files:
MARI_PCB_Final_IMU/Core/Src/main.c:
Copyright (c) 2026 STMicroelectronics.
All rights reserved.
This software is licensed under terms that can be found in the LICENSE file
parts and their libraries:
STM32F756VGT6: COPYRIGHT: Copyright (C) 2025 Ultra Librarian. All rights reserved.
2026-03-13_21-53-50_Library: COPYRIGHT: Copyright (C) 2026 Ultra Librarian. All rights reserved.
